sunzcdev/arduino-n150/NIGHT_REPORT.md

# 夜班报告 · Arduino UNO 声光项目（2026-09-25 深夜 ~ 09-26 凌晨）

> 你在凌晨 1 点收工，这是按你交代做的四件事：**内化成果 → 审问题并修 → 调研新玩法 → 写这份汇报**。
> 所有结论都来自实机实测，未验证的都标了「待确认」。

---

## 一、今天做成了什么（按时间顺序，全部实机验证）

| 阶段 | 成果 | 关键数据 |
|---|---|---|
| 上午 | 蜂鸣器演奏链路 | 《晴天》307 音事件 / 102 秒 / **零丢音** |
| 傍晚 | 音频流（串口推采样） | 数字通路零欠载 1875 帧，**但压电片放不出语音 → 判定死路**（见下） |
| 夜里 | 三色灯效引擎 | 3 灯共阴（红D5/绿D6/蓝D9）+ 8 种图案 + 逐色标定 |
| 夜里 | **灯随旋律** | 音高→色相（全彩虹）+ 每音脉冲打拍 —— **你确认"节拍明显了"** |
| 夜里 | **双蜂鸣器声部** | 主旋律 D3 + 第二声部 D10（软件方波）—— **你确认"两路同音、不滴了"** |
| 夜里 | 混音效果 | 乒乓/齐奏/Haas/回声/和声 五种 + **分段混音器**（可按秒切换） |
| 夜里 | 任意歌曲管线 | MIDI → 单音化 → 音符表 → 灯+音乐；《有何不可》全曲 210 秒零丢音 |

**一句话总结**：从"一只蜂鸣器放个响"做到了**"两只蜂鸣器 + 三颗灯，能按原曲分段做声光表演"**，而且换歌不用改固件。

---

## 二、审出的问题（14 个）—— 根因与状态

### 已修（全部实测验证）

| # | 现象 | 根因（真身） |
|---|---|---|
| 1 | 蜂鸣器放不出语音 | 压电片是窄带谐振器、靠**载波旁带**出声：62.5kHz 载波的旁带落在人耳外（死寂），降到 7.8k/1.95k 只出蟋蟀/知了叫 → **这条路对压电片是死的**，已放弃 |
| 2 | 曲终出现 288ms "缺口" | 记账语义错：曲终静音被算成欠载 → 改为"恢复播放时才结算" |
| 3 | 每秒 2~5ms 假欠载 | 统计打印阻塞 `loop()` 1.5ms > RX 缓冲 2.5ms → 改非阻塞打印 |
| 4 | 开串口后板子不响应 | DTR 复位板子，预滚帧喂给了 bootloader → 加握手等就绪 |
| 5 | 整条流哑掉且不报错 | 丢一个字节让解析状态机永久卡死 → 加 60ms 帧超时 |
| 6 | 灯的蓝色一次没用上 | 色相范围写死 240~1100Hz，而本曲只在 262~698Hz → 按本段音域撑满 |
| 7 | 灯色被污染 | 板载 D13 灯（已软件关掉）+ 电源灯/TX-RX 灯（硬连线，只能贴胶带） |
| 8 | 低音"刺啦" | **我 CTC 模式算错**：OC1B 每周期只翻转一次，我按两次算 → 输出低一个八度 → 压电片亚谐振区大幅摆动、机械摩擦出声 |
| 9 | 低音高音"滴滴滴" | **引脚抢定时器**：蓝色 LED 在 D9 = Timer1 的 OC1A，灯的 `analogWrite` 把 Timer1 抢走；加上我每次换音都重启定时器 |
| 10 | D10 彻底没声 | 我写的 `if (TCCR1B==0)` 保险 → 配置永远不生效 → **改为软件方波，不占任何定时器** |
| 11 | 两个声部"乱弹琴" | **两条时间轴各自缩水**：主旋律表短 16.0 秒、低音表短 18.0 秒（<60ms 的间隙没计入）→ 越走越错开 2 秒 → 改用 MIDI 直算的**绝对起始时间** |
| 12 | 低音内容乱 | 逐时间片取最低音 → 抓到的是钢琴左手的琶音跳音 → 改「按拍取根音」或走同音域混音 |

### 还开着（等你）

| # | 待办 | 需要你做什么 |
|---|---|---|
| 13 | **音量不平衡**（D3 响、D10 轻） | ① **先叫我烧固件**（D7→D12 的改动我没在半夜烧，怕开机自检那两声吵到你）② 再把 D10 那只蜂鸣器的**短脚从 GND 拔到 D12**（固件已支持 BTL 双端驱动，响度 +6dB） |
| 14 | **分段混音的段落边界** | 只有你知道原曲哪一段有左右声道 → 给我个大致秒数或歌词位置 |

### 流程教训（已写进技能，防复发）

- `arduino-cli compile … \| tail -2` **会吃掉编译失败的退出码** → 曾"编译失败照样跑测试"，误把旧固件的结果当新结果。改用 `set -o pipefail`。
- **改完本地文件忘了重新 scp** → "本地删了重复声明、远端还是旧文件"，白跑一轮。
- **参数与数据不匹配类 bug，靠打印值最快抓**：灯色全变成 `RGB(255,x,0)` 才发现色相范围写死。
- **先怀疑自己的数学，再怀疑硬件**：刺啦折腾四轮，最后是我的定时器算法错；硬件是最后才该怀疑的。

---

## 三、调研①：这块板子还有啥可玩的

### A 类：手边零件就能做（0 元）

| 方向 | 能做出什么 | 备注 |
|---|---|---|
| **① 红外遥控** ⭐ | 用套件里的遥控器控制板子：切灯效、切歌、调亮度、开关 | **套件里有遥控器，但红外接收头待你确认**（三脚黑色小元件）。这是最有"产品感"的方向——板子从"演示"变"设备" |
| **② 电位器** ⭐ | 旋钮实时调灯效速度/亮度/色相 | 零件现成、零风险。第一步就能让"死的图案"变成"可调" |
| **③ 按钮开关** | 切模式 / 点歌 / 静音 | 和电位器合成一个"控制面板" |
| **④ 小马达 + ULN2003** ⭐ | 精确转角 → 指针表盘 / 转盘抽奖 / **跟着节拍摆动的指针** | ⚠️ 上一轮判过"驱动板断路"，但**那是在工具很粗糙、且没做交叉验证的时候下的结论** —— 按今天的教训，**这个结论本身该重验**（10 分钟） |
| **⑤ 声光马达三合一** | 节拍 → 灯闪 + 马达摆 + 蜂鸣器响 = 一个小舞台 | 需要 ④ 先通 |
| **⑥ 主机联动（D 方向）** ⭐⭐ | **点歌服务**：你报歌名 → 自动找 MIDI → 抽旋律 → 灯+音乐自动表演 | 所有工具今天都已就绪，**只差一层壳**。零硬件成本、价值最高 |

### B 类：花几元~几十元（可选）

| 方向 | 价格 | 能做出什么 |
|---|---|---|
| **WS2812 灯环** | ~10 元 | 从"3 颗灯"跃升到"全彩灯环"：真彩虹、流星、频谱灯 —— **灯效的最大跃升** |
| 超声波 HC-SR04 | ~5 元 | 手一挥换灯效（手势控制） |
| DHT11 温湿度 | ~5 元 | 用灯色表示环境温度 |
| 光敏/人体红外 | ~2 元 | 天黑自动亮、有人来才亮 → 做"夜灯" |
| 舵机 SG90 | ~10 元 | 会动的指针/小门/机械手 |

> 你之前说过"以目前硬件做到最好" ✓ 所以 B 类只作参考，不主动买。

---

## 四、调研②：当前的灯光秀还能怎么玩

### 立刻能做（软件，0 元）

| # | 玩法 | 效果 |
|---|---|---|
| ① | **强拍白闪 + 弱拍同色微亮** | 节拍骨架更清楚（现在是"每音一闪"，升级成有强弱层次） |
| ② | **伪频谱**：音高分低/中/高三档 → 三颗灯各管一档 | 看起来像频谱分析仪 ✓ 简单有效 |
| ③ | **双声部可视化**：A 声部音高 → 色相，B 声部音高 → 亮度 | 两个声部各占一个视觉维度，信息量翻倍 |
| ④ | **乐句/段落配色**：主歌暖色、副歌冷色 | 和"分段混音"同步 → 视听一致的段落感 |
| ⑤ | **图案库扩充**：流星、雨滴、双色追逐、颜色扫过、随机火花 | 固件现有 8 个图案，可再加 |
| ⑥ | **交互化**：电位器调速度/亮度、按钮切图案、遥控切歌 | 从"播放演示"变"可操作的设备" |
| ⑦ | **亮度包络**：长音渐亮、短音急闪 | 已部分实现（脉冲），可加"音高越高越亮" |
| ⑧ | **场景化**：整点报时 / 闹钟 / 消息到达 用专属灯效 | 走 D 方向的主机联动 |

### 需要一点硬件

| # | 玩法 | 需要 |
|---|---|---|
| ⑨ | **真彩虹/流星/频谱** | WS2812 灯环（~10 元）|
| ⑩ | **更均匀的混色** | 多层散光（描图纸/磨砂片）+ 三灯紧贴 —— 0 元也能试 |
| ⑪ | **手势/环境触发灯效** | 超声波 / 光敏（各几元）|

---

## 五、建议的明天路线（按性价比排序）

1. **收尾三件小事**（各 5~10 分钟）：接 BTL 那根线（音量平衡）→ 定分段边界（你报位置，我设参数）→ 配色配比标定（B/C 组二选一，我固化进脚本）
2. **重验电机/ULN2003**（10 分钟）：把那个"断路"旧结论验掉 —— 如果通，就有"跟着节拍摆动的指针"这个新玩法
3. **D 方向：点歌服务**（最有价值）：你在 Discord 报歌名 → 板子自动配色开弹，把今天所有工具串成一个产品
4. 红外遥控可行性确认（先看你套件里有没有红外接收头）

---

## 附：今天的实测数据（备查）

- **《有何不可》**：691 事件 / 199.8 秒谱面 / 210.1 秒实放 / 零丢音；音域 C4~C6（262~1047Hz）
- **时间轴偏差**（修前）：主旋律表累加值短 16.0 秒、低音表短 18.0 秒 → 两声部最大错开约 2 秒
- **低音抽法对比**：逐片取最低音 = 619 事件（2.9 音/秒，乱跳）→ 按拍取根音 = 241 事件（1.1 音/秒，长音持续）；MIDI 速度 110 BPM → 拍长 545ms
- **固件占用**：9566 字节 / 29%（flash）、SRAM 441 字节 / 21%
- **段落密度**（5 秒桶，用于定位主歌/副歌，副歌=密度高、时值短）：
  - 0-20s 高音区琶音（前奏）→ 20-50s 密度 3.4~4.0 → 100-120s 密度 4.4/4.0（**最密 = 副歌候选**）→ 125-140s 密度 3.6~3.8 → 200s 后渐稀（尾奏）
- **文件清单**：`~/projects/arduino-n150/`（本地）↔ `xingzhe:~/arduino/`（板上）
  - 固件：`n150-uno-lights3/`（灯+双声部，当前）、`n150-uno-buzzer/`（单声部音乐）、`n150-uno-audio/`（音频流，已弃）
  - 播放：`play_duet.py` / `play_mix.py` / `play_notes.py` / `play_show.py`
  - 数据：`build_song.py` / `build_bass.py` / `inspect_midi.py` / `find_sections.py`
  - 测试：`duet_check.py` / `high_test.py` / `swap_test2.py` / `bass_diag.py` / `calibrate.py` / `led_verify.py`
- **技能**：`arduino-uno-lights-duet`（今晚新建）、`arduino-uno-buzzer-melody`、`arduino-uno-piezo-audio`（死路记录）
