sunzcdev/arduino-n150/诊断结论.md

# n150 UNO 蜂鸣器诊断结论（第 3 轮）

## 溯源：套件官方清单（用户提供，一锤定音）
用户买的是「Arduino 创客编程学习套件 · 标准版」，清单第 21、22 项分别为：
- **21. 有源蜂鸣器** ×1
- **22. 无源蜂鸣器** ×1

→ **套件出厂就只有各一只**（厂家设计意图：有源做"会叫就行"的实验，无源做音调/音乐实验）。
→ 结论：**盒内物理上只有一个无源蜂鸣器，双声部旋律用盒内配件做不到**，与三轮实测完全一致。
→ 实物分辨：顶部贴黑色胶纸/底部封死看不到线圈 = **有源**；顶部裸露、底部见绿色 PCB + 铜线圈 = **无源**。两只外观极像，务必用油性笔做记号。

### 补货规格（A 方案）
`无源蜂鸣器 5V 电磁式 12mm 2脚` ×2 只（一只上机、一只备用；务必"无源/passive"）

## 硬件现状（实测）

| 通道 | 引脚 | 器件类型 | 判据 |
|---|---|---|---|
| 第一声部（旋律） | D3 | **无源蜂鸣器**（低阻抗电磁式） | ① 直流 600ms 只「咔」一声（不自振）② 命令 200/800/2000Hz → 听到**低→高**（音高跟随命令） |
| 第二声部（低音） | D10 | **有源蜂鸣器**（自带振荡器，约 2kHz） | ① 直流 600ms → **持续响**（自振）② 命令 200/800/2000Hz → 听到**高→低**（音高不跟随；2000Hz 门控 ≈ 内部振荡频率，产生互调差音 → 听感反而变低） |

电学探测（`Z` 命令，35kΩ 上拉）：两只都读到 LOW → **两只都是低阻抗（电磁式），不是压电片**。
→ 由此确认：**之前"压电片靠高次谐波激励"的判断是错的**，占空比测试（50%→10% 音量不变）就是第一个反证。

## 根因

**两只蜂鸣器不是同一型号 —— 一只有源、一只无源。** 这是"第二声部音量怎么调都上不来"的根本原因，与固件、占空比、BTL 全都无关：

- **有源蜂鸣器音高不可控**：它自带振荡器，给什么频率都唱自己那个固定音高（直流也响）。所以它**原理上无法充当"声部"**，只能当固定音高的"嗒"声/节拍。
- 用旋律方波去驱动有源蜂鸣器 → 内部振荡被门控削波 → **就是那个"刺啦"声**。
- 无源那只的谐振峰在高频段（典型 2~4kHz）→ **低频弱、高音突出** → 解释了"高音总是滴滴滴"。

## 佐证：故障跟着器件走，不跟着引脚走

用户把两只蜂鸣器对调后，"响/不响"的分工**跟着蜂鸣器走**（不跟着引脚走）→ 这是在版级排故里最干净的"故障随器件迁移"证据，直接锁定器件而非焊点/引脚/固件。

## 解决路径

### A. 治本（推荐，几块钱）
买**一对同型号的"无源"蜂鸣器**（关键词：`无源蜂鸣器 5V 电磁式 12mm 2脚`，¥1~2/个，注意是"无源/passive"不是"有源/active"）。
一只接 D3 走旋律，一只接 D10（或 D10+/D12 BTL）走低音。之后占空比、BTL、软件平衡才全部有效。

### B. 不花钱（编曲适配）
- D3（无源）：**旋律 + 低音分时复用** —— 旋律的空隙里插低音，变成"带伴奏的单声部"。
- D10（有源）：**只做拍点/重音** —— 每拍敲一下固定音高的"嗒"，当鼓用。这是唯一合理用法，很多玩具就是这么干的。

## 已排除（不必再试）
- ✗ 调占空比（50%/30%/20%/10% 实测音量无变化）
- ✗ BTL 反相驱动（能加约 +6dB，但救不了音高不可控）
- ✗ 改固件（`bassHalfUs = 500000UL / f` 映射正确，无反向 bug）
- ✗ 引脚/器件对调（已做，故障随器件迁移 → 证明是器件问题）
