sunzcdev/arduino-n150/heyibuhe_notes.txt

# 来源: /tmp/heyibuhe.mid 轨1（单音化：每时间片取最高音）
# 音域 C4~C6 (60-84) | 移调 +0 半音
# 事件 691 条（含休止）| 总时长 199.8s
# 列: 频率Hz 时值ms 绝对起始ms（起始时间直接来自 MIDI，覆盖累加值 → 两声部精确对齐）
698 68 0
0 205 68
698 68 273
0 205 341
698 68 545
0 205 614
698 68 818
0 205 886
698 68 1091
0 205 1159
698 68 1364
0 205 1432
698 68 1636
0 205 1705
698 68 1909
0 205 1977
698 245 2182
698 245 2455
698 245 2727
880 245 3000
0 1118 3245
698 245 4364
698 245 4636
698 245 4909
784 245 5182
0 1118 5427
698 245 6545
698 245 6818
698 245 7091
880 245 7364
0 1118 7609
698 245 8727
698 245 9000
698 245 9273
1047 245 9545
1047 245 9818
880 245 10091
698 245 10364
523 245 10636
698 245 10909
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
