sunzcdev/arduino-n150/breadboard_anatomy.png

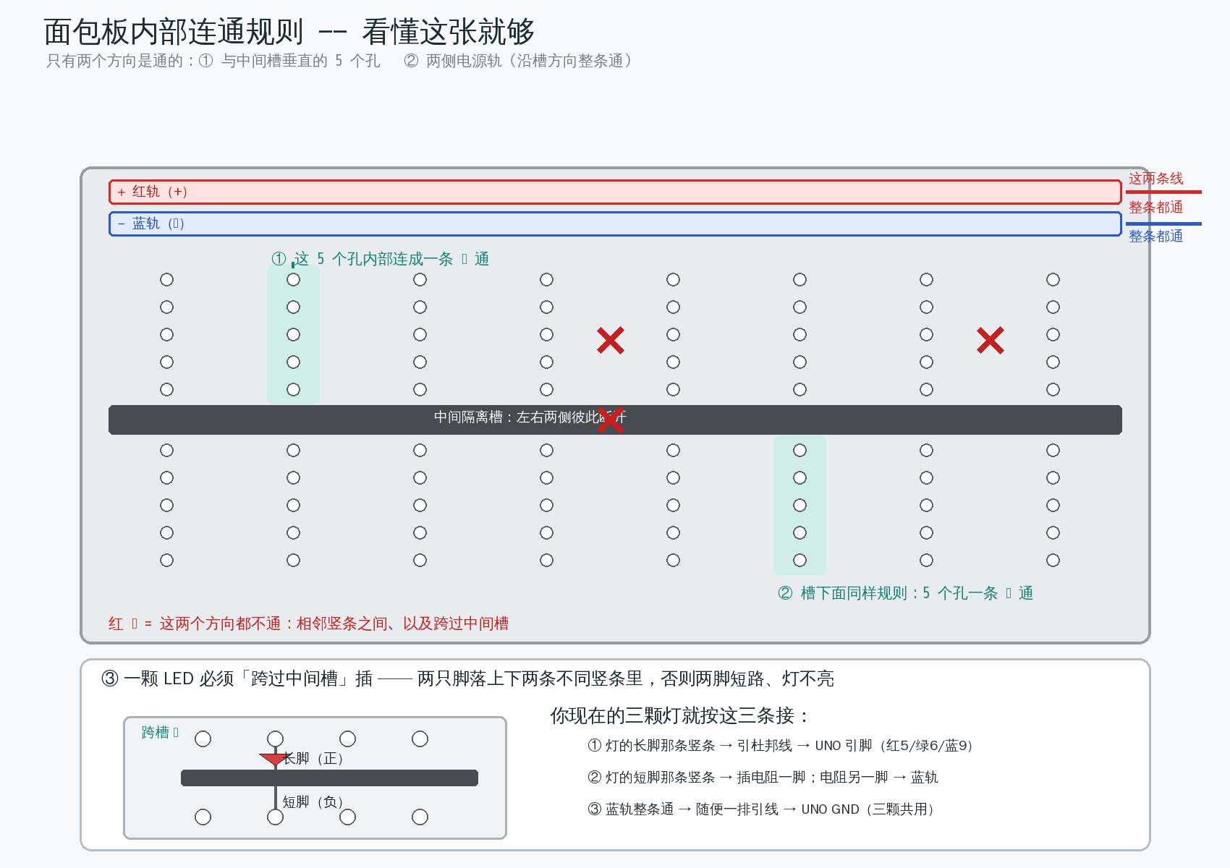
breadboard_anatomy.png
