sunzcdev/arduino-n150/接线图_v10.png

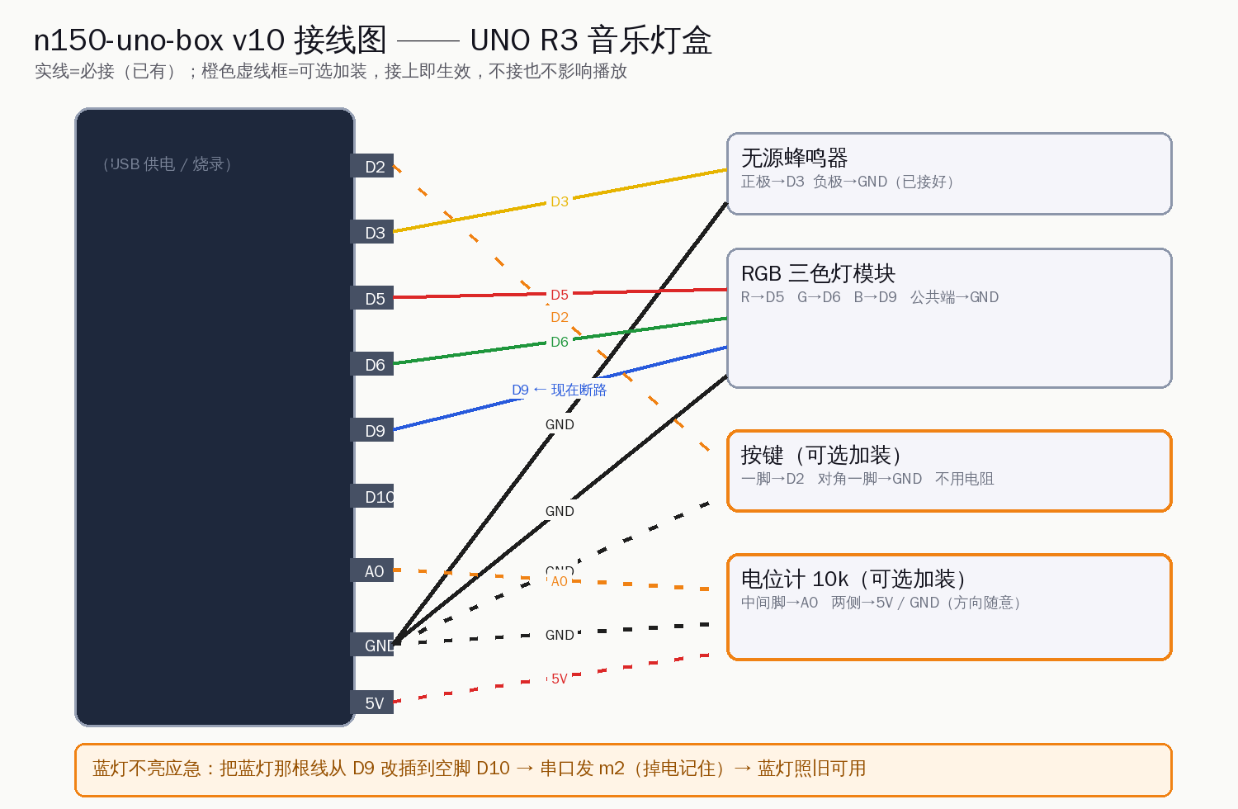
接线图_v10.png
