sunzcdev/arduino-n150/led_wiring.png

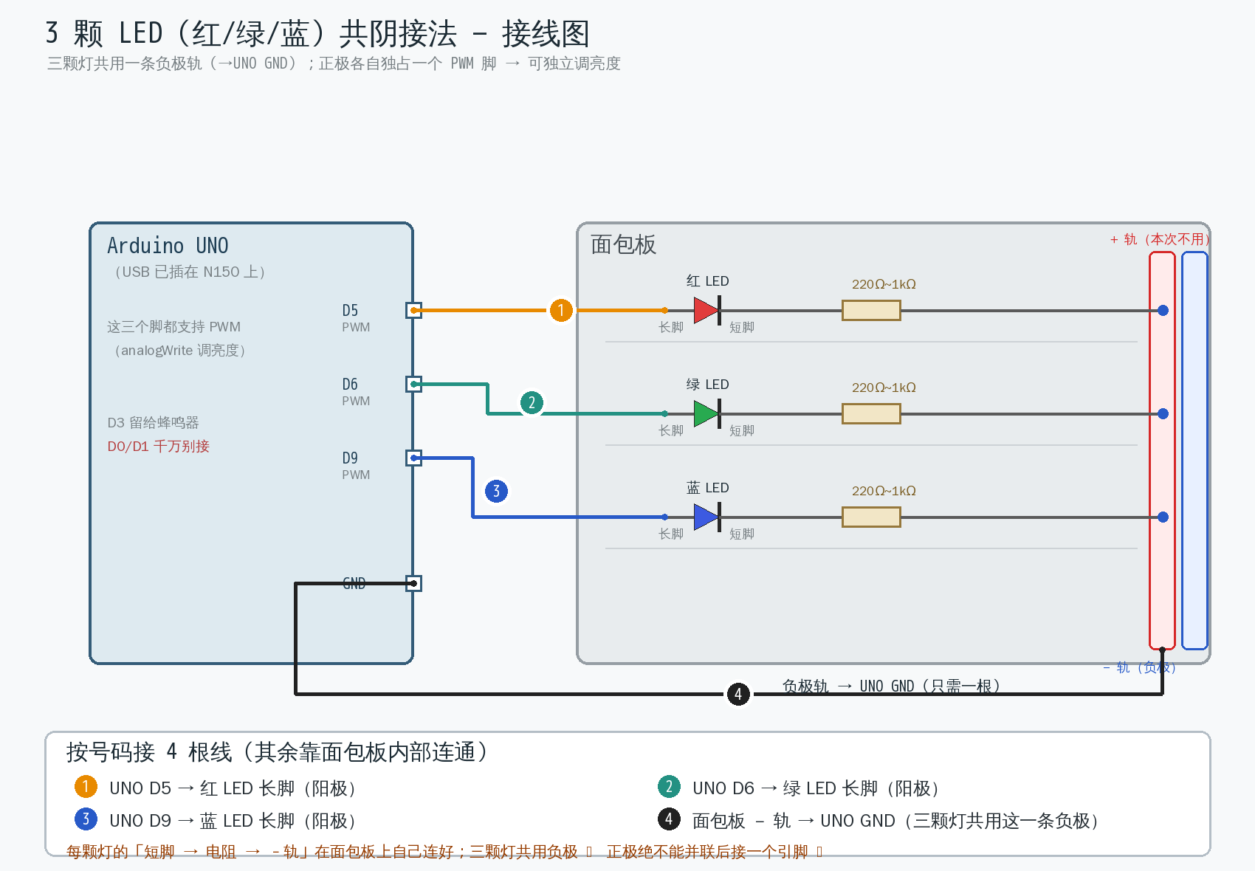
led_wiring.png
