sunzcdev/arduino-n150/wiring.png

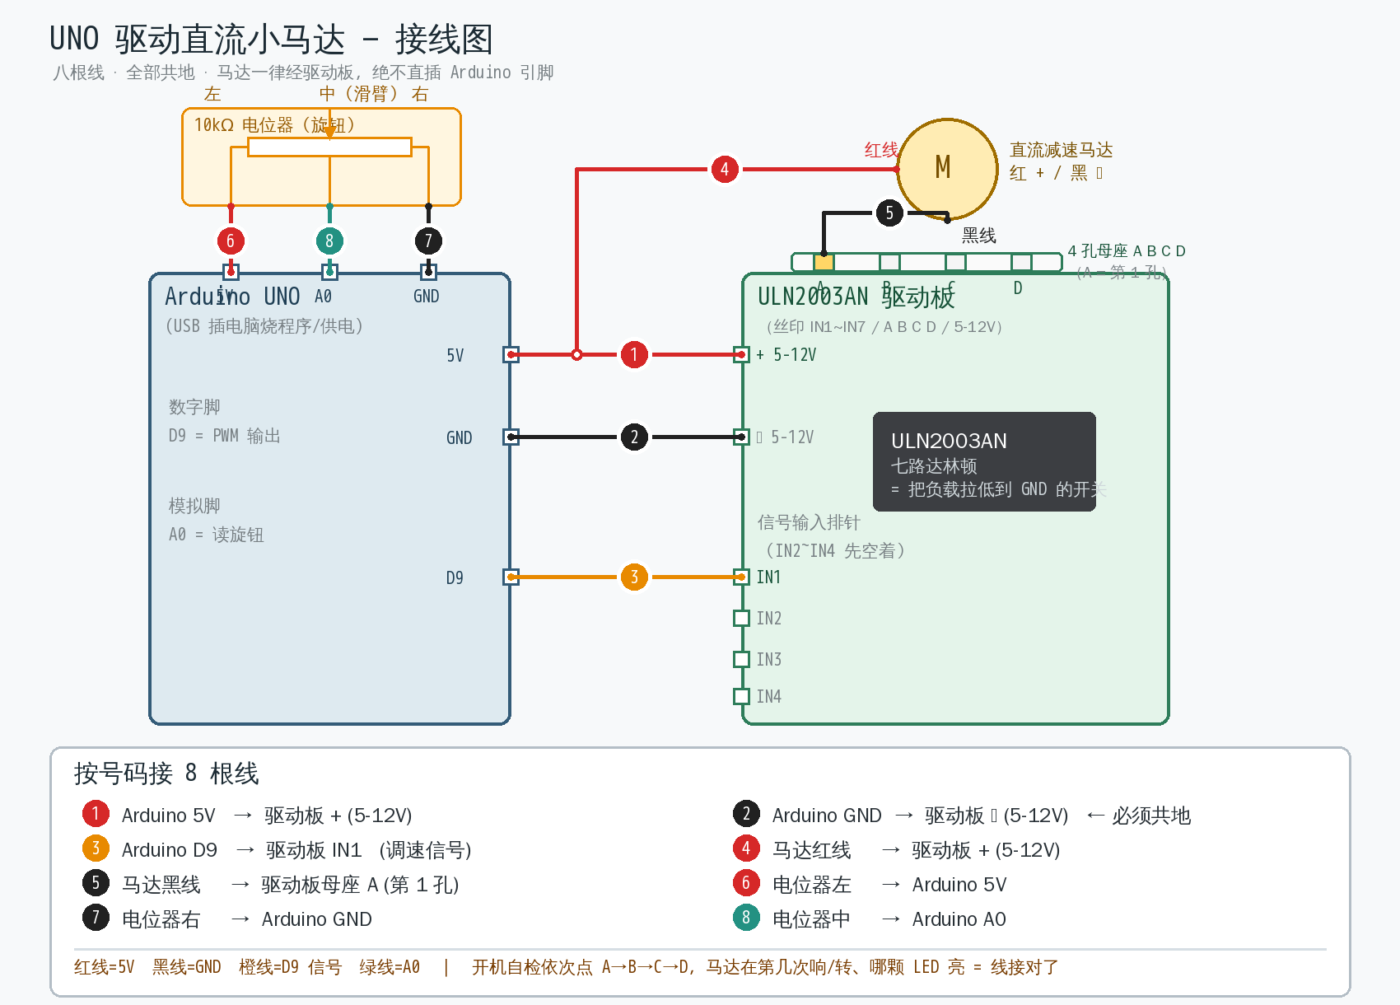
wiring.png
