sunzcdev/arduino-n150/n150-uno-box/songs.h

// songs.h — 曲库（自动生成，勿手改；生成器 tools/make_songs.py）
// 共 5 首，全部放 PROGMEM（UNO 只有 2KB SRAM）
// 数据量 3280 字节，约占 flash 10.0%
#ifndef SONGS_H
#define SONGS_H
#include <avr/pgmspace.h>

struct Song {
  uint16_t      n;      // 事件数
  const uint16_t* f;    // 频率 Hz（0 = 休止）
  const uint16_t* d;    // 时值 ms
  uint16_t      lo, hi; // 本曲音域，用于音高→色相归一化
  const char*   name;   // PROGMEM 字符串
};

// --- 0. 有何不可(主旋律) | 691 事件 | 199.8s | 音域 262~1047Hz ---
const uint16_t S0_F[] PROGMEM = {
  698,0,698,0,698,0,698,0,698,0,698,0,698,0,698,0,698,698,698,880,0,698,698,698,784,0,698,698,
  698,880,0,698,698,698,1047,1047,880,698,523,698,698,698,880,0,698,698,698,784,0,698,698,523,
  698,784,880,698,784,880,698,880,659,698,1047,659,698,1047,659,698,1047,659,698,1047,1047,0,
  349,349,349,523,523,392,392,392,392,392,349,330,349,349,349,349,349,349,349,349,349,349,523,
  349,349,523,523,523,523,523,523,523,523,523,349,392,349,349,349,349,262,262,440,440,466,466,
  466,466,466,466,523,392,0,349,349,349,523,523,392,392,392,392,392,440,466,440,440,440,440,440,
  392,349,349,330,659,659,587,587,523,440,392,349,349,349,349,349,392,440,349,349,349,349,349,
  349,392,440,349,466,466,466,440,466,523,440,440,392,349,349,392,392,349,440,0,349,349,392,392,
  349,523,0,523,523,587,587,523,698,0,698,698,659,587,659,523,0,523,523,440,440,392,349,0,349,
  349,392,392,349,440,523,523,440,349,349,349,392,392,392,349,349,294,440,440,392,349,349,392,
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

const Song SONGS[] = {
  { S0_N, S0_F, S0_D, S0_LO, S0_HI, S0_NAME },
  { S1_N, S1_F, S1_D, S1_LO, S1_HI, S1_NAME },
  { S2_N, S2_F, S2_D, S2_LO, S2_HI, S2_NAME },
  { S3_N, S3_F, S3_D, S3_LO, S3_HI, S3_NAME },
  { S4_N, S4_F, S4_D, S4_LO, S4_HI, S4_NAME },
};
const uint8_t NSONGS = 5;

#endif
