sunzcdev/arduino-n150/(commit log)

2026-09-26 v10.3-final: Z 电测改 ADC 电压判据 + 裸脚基准；蓝灯D9已通(2506~2711mV)已确认
2026-09-26 声学闭环验收工具链；交接空隙根因修正（实测 0.2s，真凶=重开流 2.2/8.2s）
2026-09-26 收尾：资产体检脚本；vol_sample 采用 skill 版（原版注释把音量非0当成功放醒着=逻辑越界）
2026-09-26 锚点修正：hybrid_show 打印 t0_wall 作录音锚点；duet_check 录音长度计入板子握手 4~5s
    [hybrid_show.py]
2026-09-26 整曲验收：full_run_report 报告工具；env_scan 起录咔哒免疫；duet_check 记录音起点+修 bash 浮点算术；show_audit/board_selftest/preflight_check 入册
2026-09-26 v10.4 固件吞音修复（autoStop 无条件 noTone 掐掉起音）+ 音符表重转写 + 声学验收工具链；清理 .pyc 并加 .gitignore
    [analyze_bands.py, analyze_effect1.py, analyze_heyibuhe.py, analyze_local.py, effect1_chorus.py, handover_calc.py, hybrid_show.py, mute_all.py]
2026-09-26 补：音频结构分析（structure/structure2）+ 灯效测试工具（tools/light_test.py）
2026-09-26 gitignore: 补 stignore_music.txt（Syncthing 忽略表，属本机运维）
